cvetaevvitaliy/telemetry-system/doc/pic/GPS_module_1.png

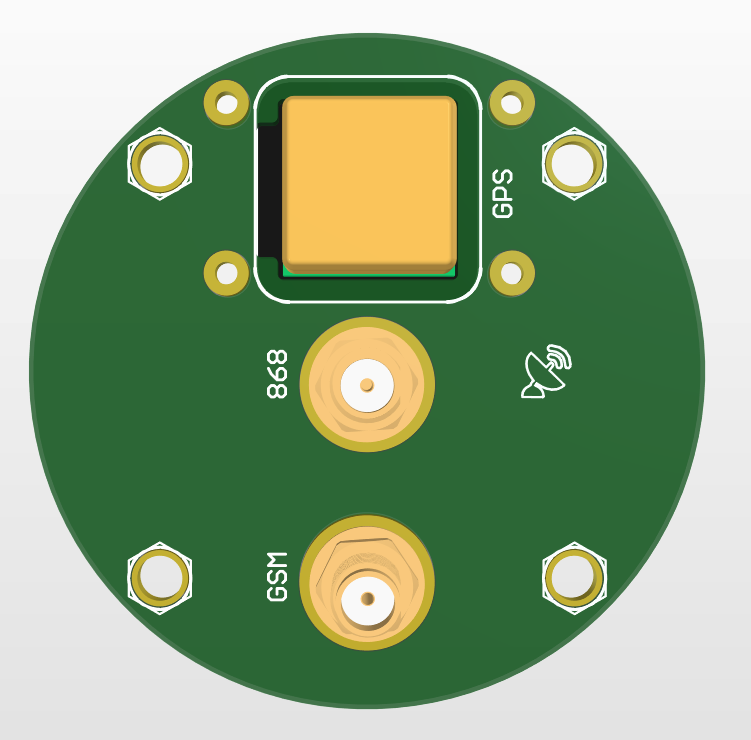
doc/pic/GPS_module_1.png
