cvetaevvitaliy/telemetry-system/doc/pic/GPS_module_2.png

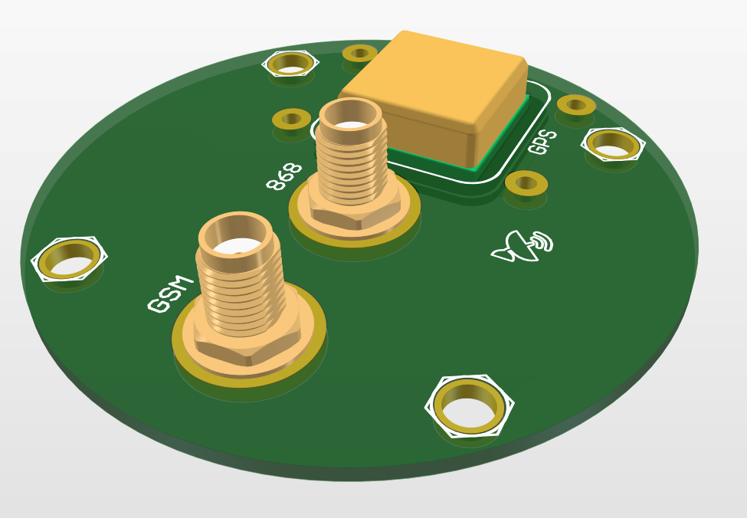
doc/pic/GPS_module_2.png
