cvetaevvitaliy/telemetry-system/doc/pic/Ground_station.png

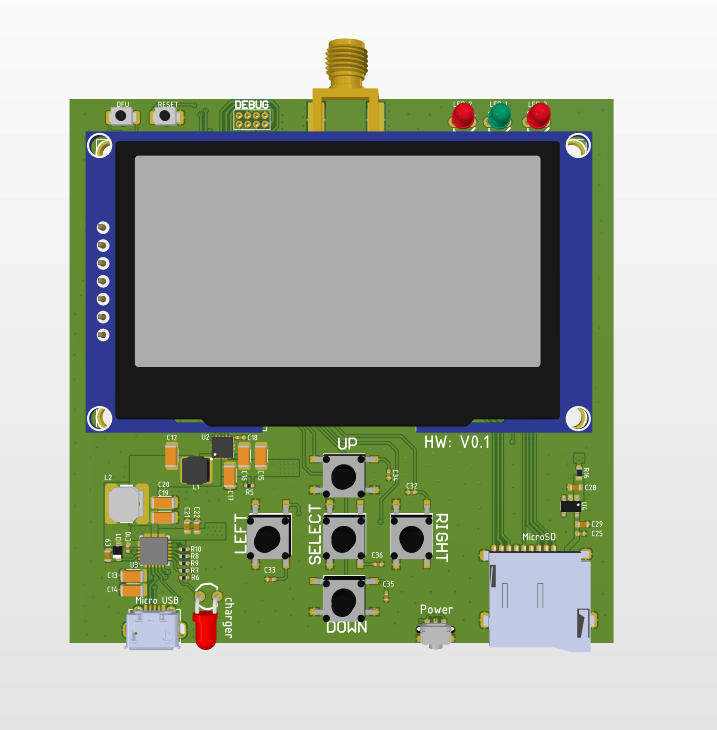
doc/pic/Ground_station.png
