cvetaevvitaliy/telemetry-system/doc/pic/MCU_module_B.png

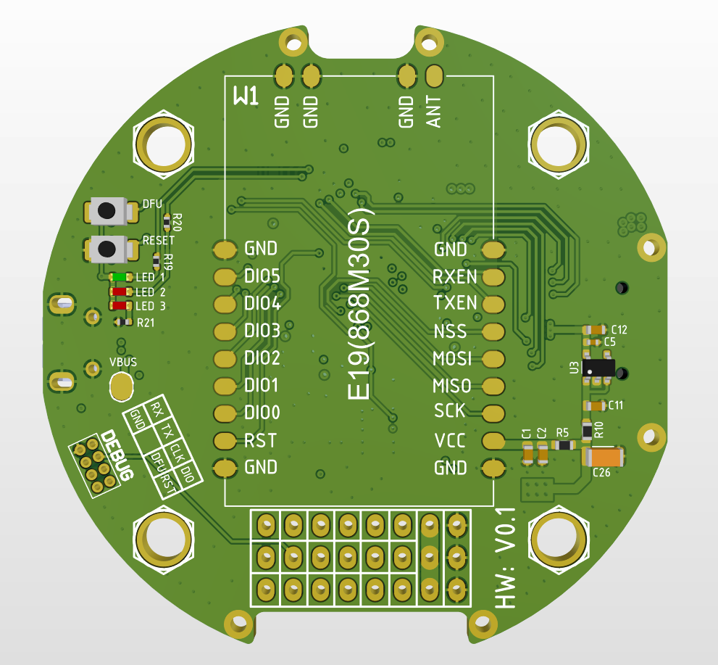
doc/pic/MCU_module_B.png
