cvetaevvitaliy/telemetry-system/doc/pic/MCU_module_T.png

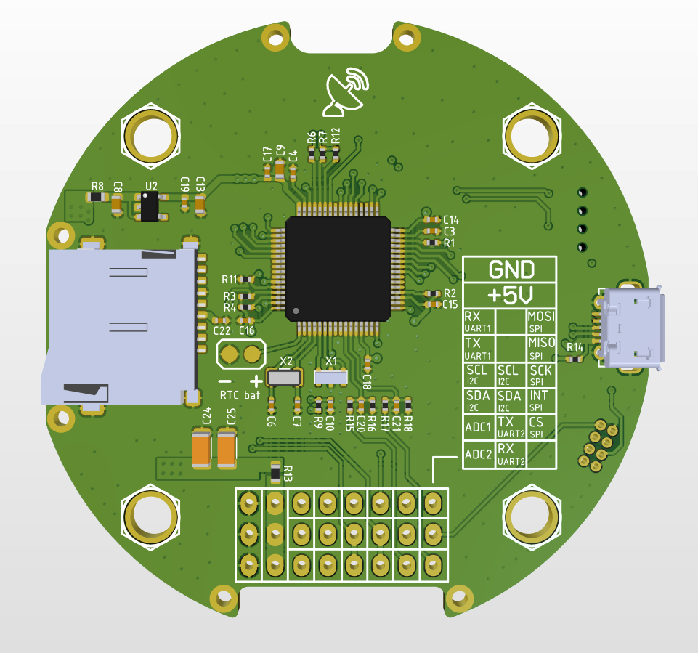
doc/pic/MCU_module_T.png
