cvetaevvitaliy/telemetry-system/doc/pic/POWER_module_B.png

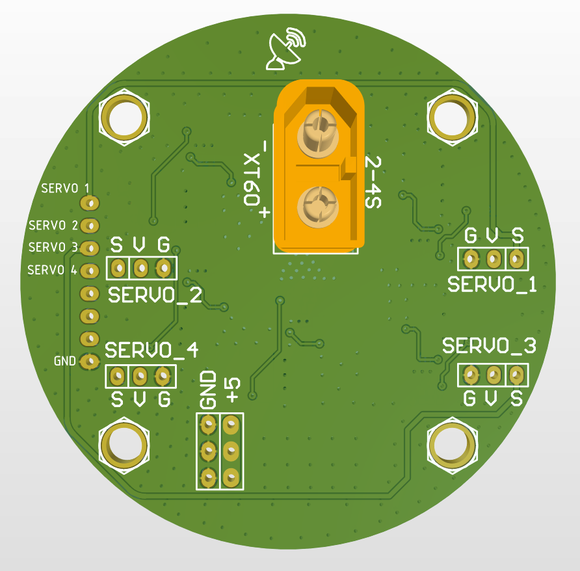
doc/pic/POWER_module_B.png
