cvetaevvitaliy/telemetry-system/doc/pic/POWER_module_T.png

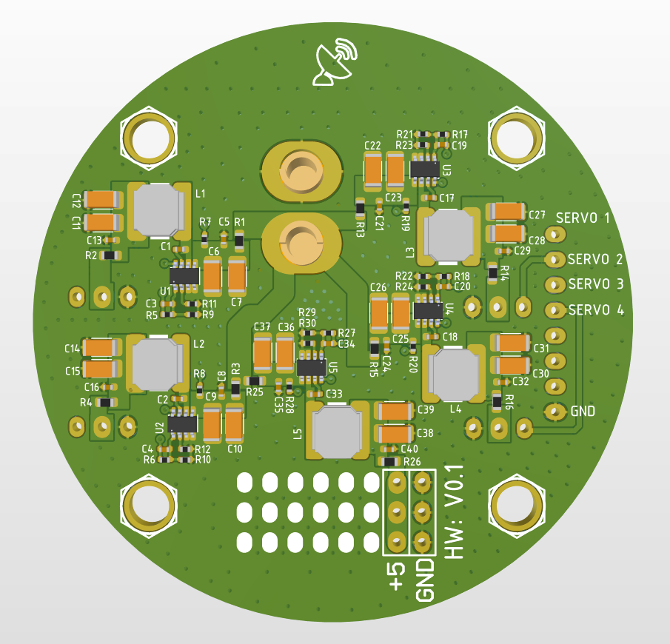
doc/pic/POWER_module_T.png
