cvetaevvitaliy/telemetry-system/doc/pic/SERVO_module_B.png

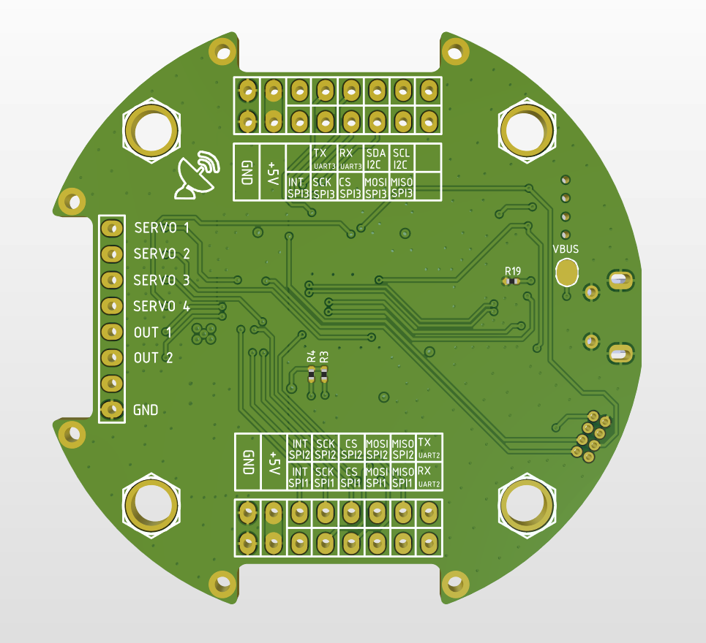
doc/pic/SERVO_module_B.png
