cvetaevvitaliy/telemetry-system/doc/pic/SERVO_module_T.png

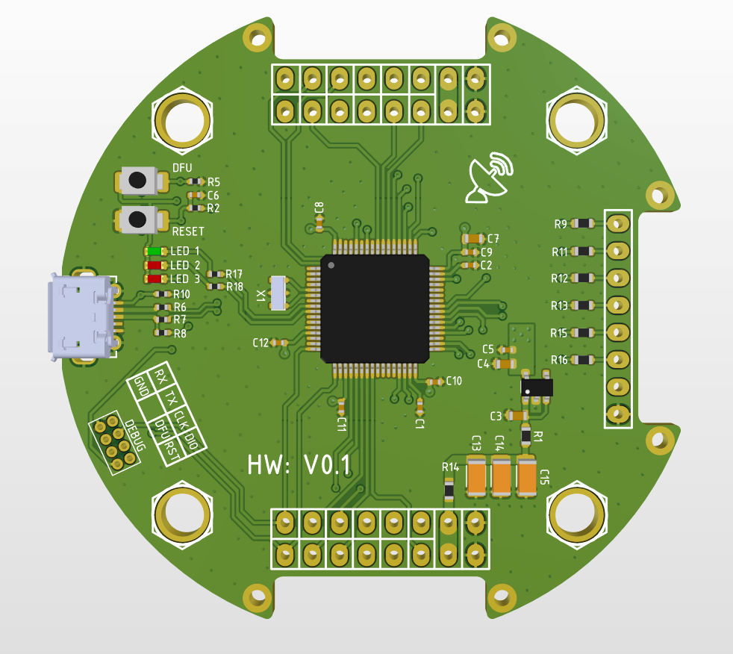
doc/pic/SERVO_module_T.png
