cvetaevvitaliy/telemetry-system/doc/pic/TX.png

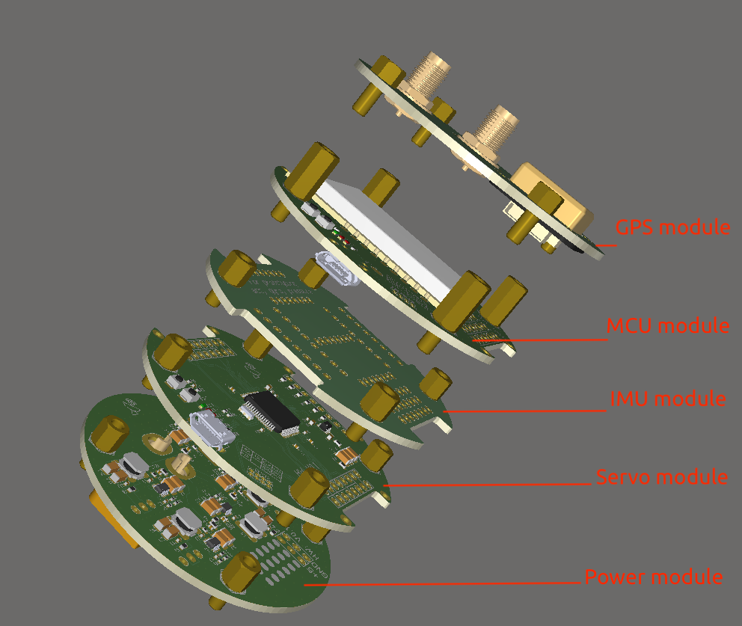
doc/pic/TX.png
