cvetaevvitaliy/telemetry-system/doc/pic/TX_assem.png

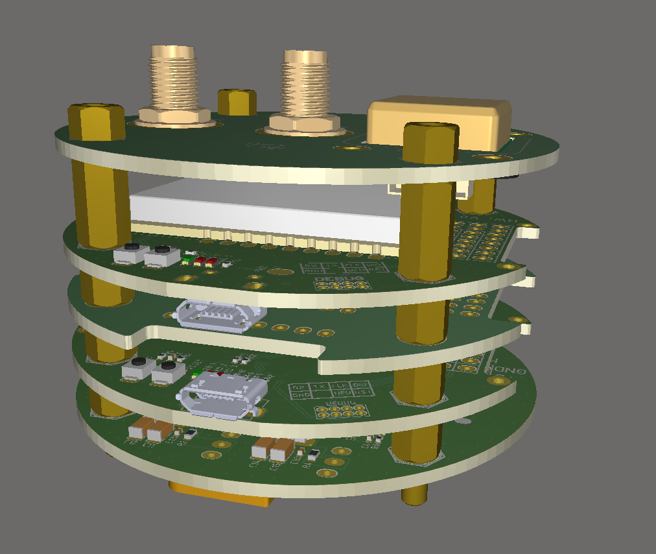
doc/pic/TX_assem.png
