cvetaevvitaliy/telemetry-system/src/components/README.md

# Components
The source code of the project components is stored here
------

### bq25895 source code
Source code for i2c charger chip

```
📦 bq25895
 ┣ 📜 bq2589x_charger.c
 ┣ 📜 bq2589x_charger.h
 ┗ 📜 bq2589x_reg.h
```
------

### CLI - Command Line Interface
Compact & Simple Command Line Interface for microcontrollers <br>
Uses ~2Kb Flash memory, ~1Kb RAM memory

```
📦 cli
 ┣ 📂 lib
 ┃ ┣ 📜 cli_input.c
 ┃ ┣ 📜 cli_input.h
 ┃ ┣ 📜 cli_log.c
 ┃ ┣ 📜 cli_log.h
 ┃ ┣ 📜 cli_queue.c
 ┃ ┣ 📜 cli_queue.h
 ┃ ┣ 📜 cli_time.c
 ┃ ┗ 📜 cli_time.h
 ┣ 📜 cli.c
 ┣ 📜 cli.h
 ┣ 📜 cli_config.h       - config CLI header file
 ┣ 📜 cli_io.c
 ┗ 📜 cli_io.h
```

------

### LoRa transceiver source code
Source code for SX1276 chip

```
📦 sx1276
 ┣ 📜 radio.h
 ┣ 📜 sx1276-board.h
 ┣ 📜 sx1276.c
 ┣ 📜 sx1276.h
 ┣ 📜 sx1276Regs-Fsk.h
 ┗ 📜 sx1276Regs-LoRa.h
```

------

*the document will be updated as the project develops
