cvetaevvitaliy/telemetry-system/doc/HW/Ground_station_RX.pdf

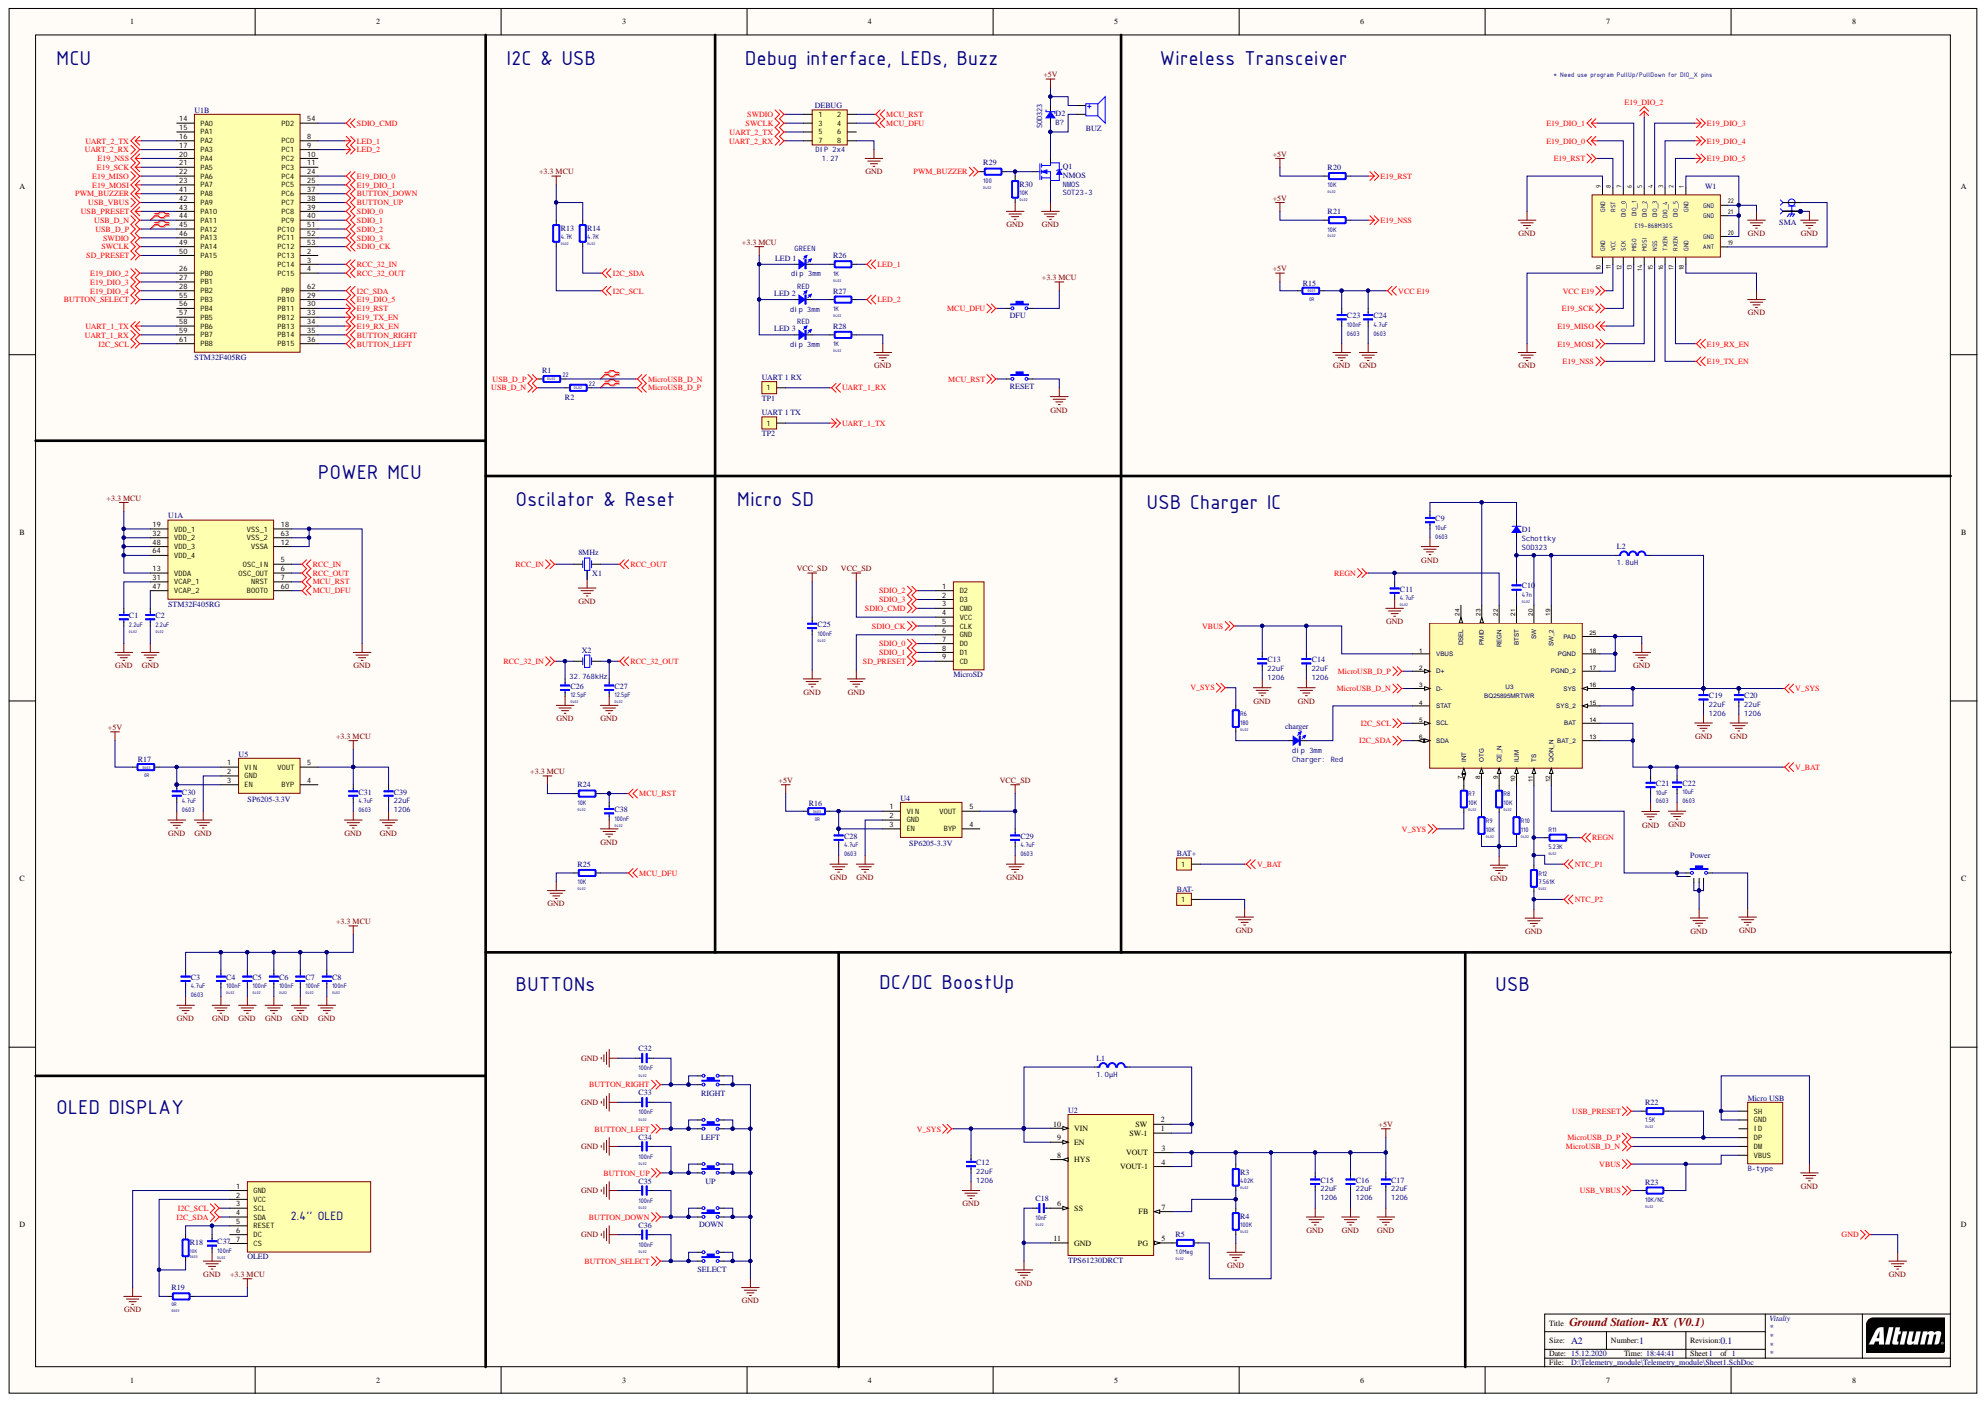
[picture p15: page 1]

* Need use program PullUp/PullDown for DIO_X pins

GND 1 DIO_5 2 DIO_4 3 DIO_3 4 DIO_2 5 DIO_1 6 DIO_0 7 RST 8 GND 9 GND 10

8MHz X1 +3.3 MCU | VCC_SD +5V VCC_SD

VDDA 13

I2C_SCL I2C_SDA | SCL 3

VCC 2

Ground Station- RX (V0.1) Title | Vitaliy * * * *

Size: A2 | Number: 1 | Revision: 0.1

Date: 15.12.2020 Time: 18:44:41 | | Sheet 1 of 1

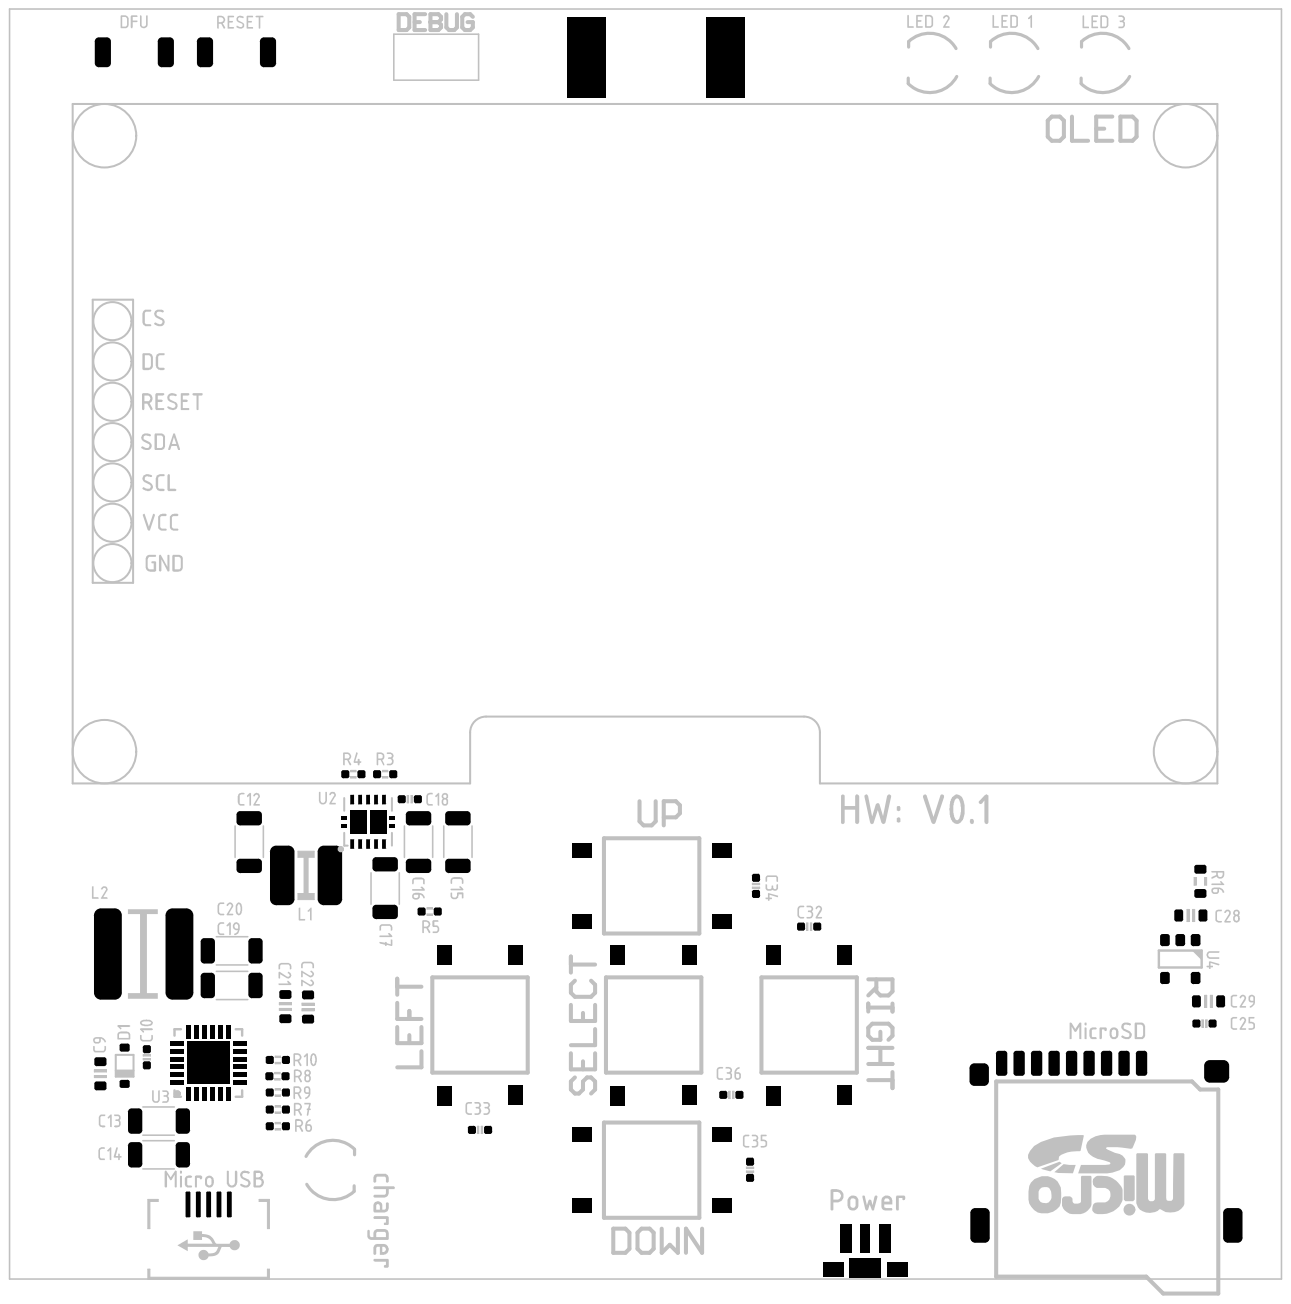
[picture p16: page 2]

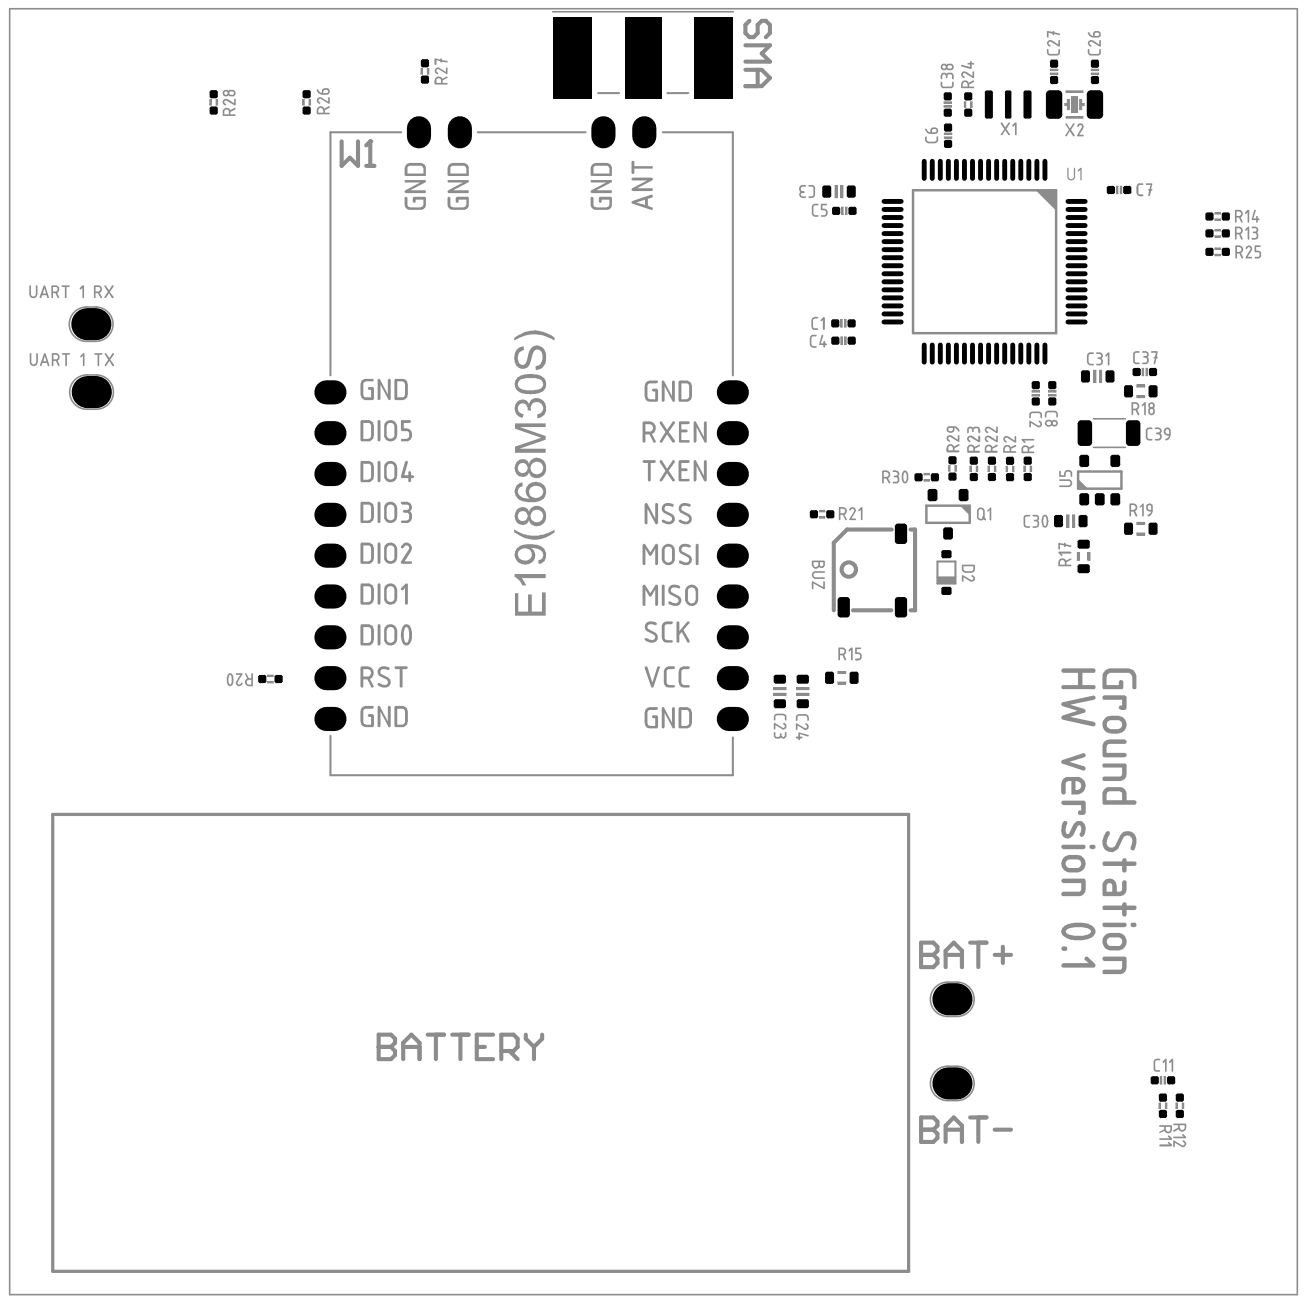
[picture p17: page 3]
