cvetaevvitaliy/telemetry-system/doc/HW/Telemetry_module_TX_MCU.pdf

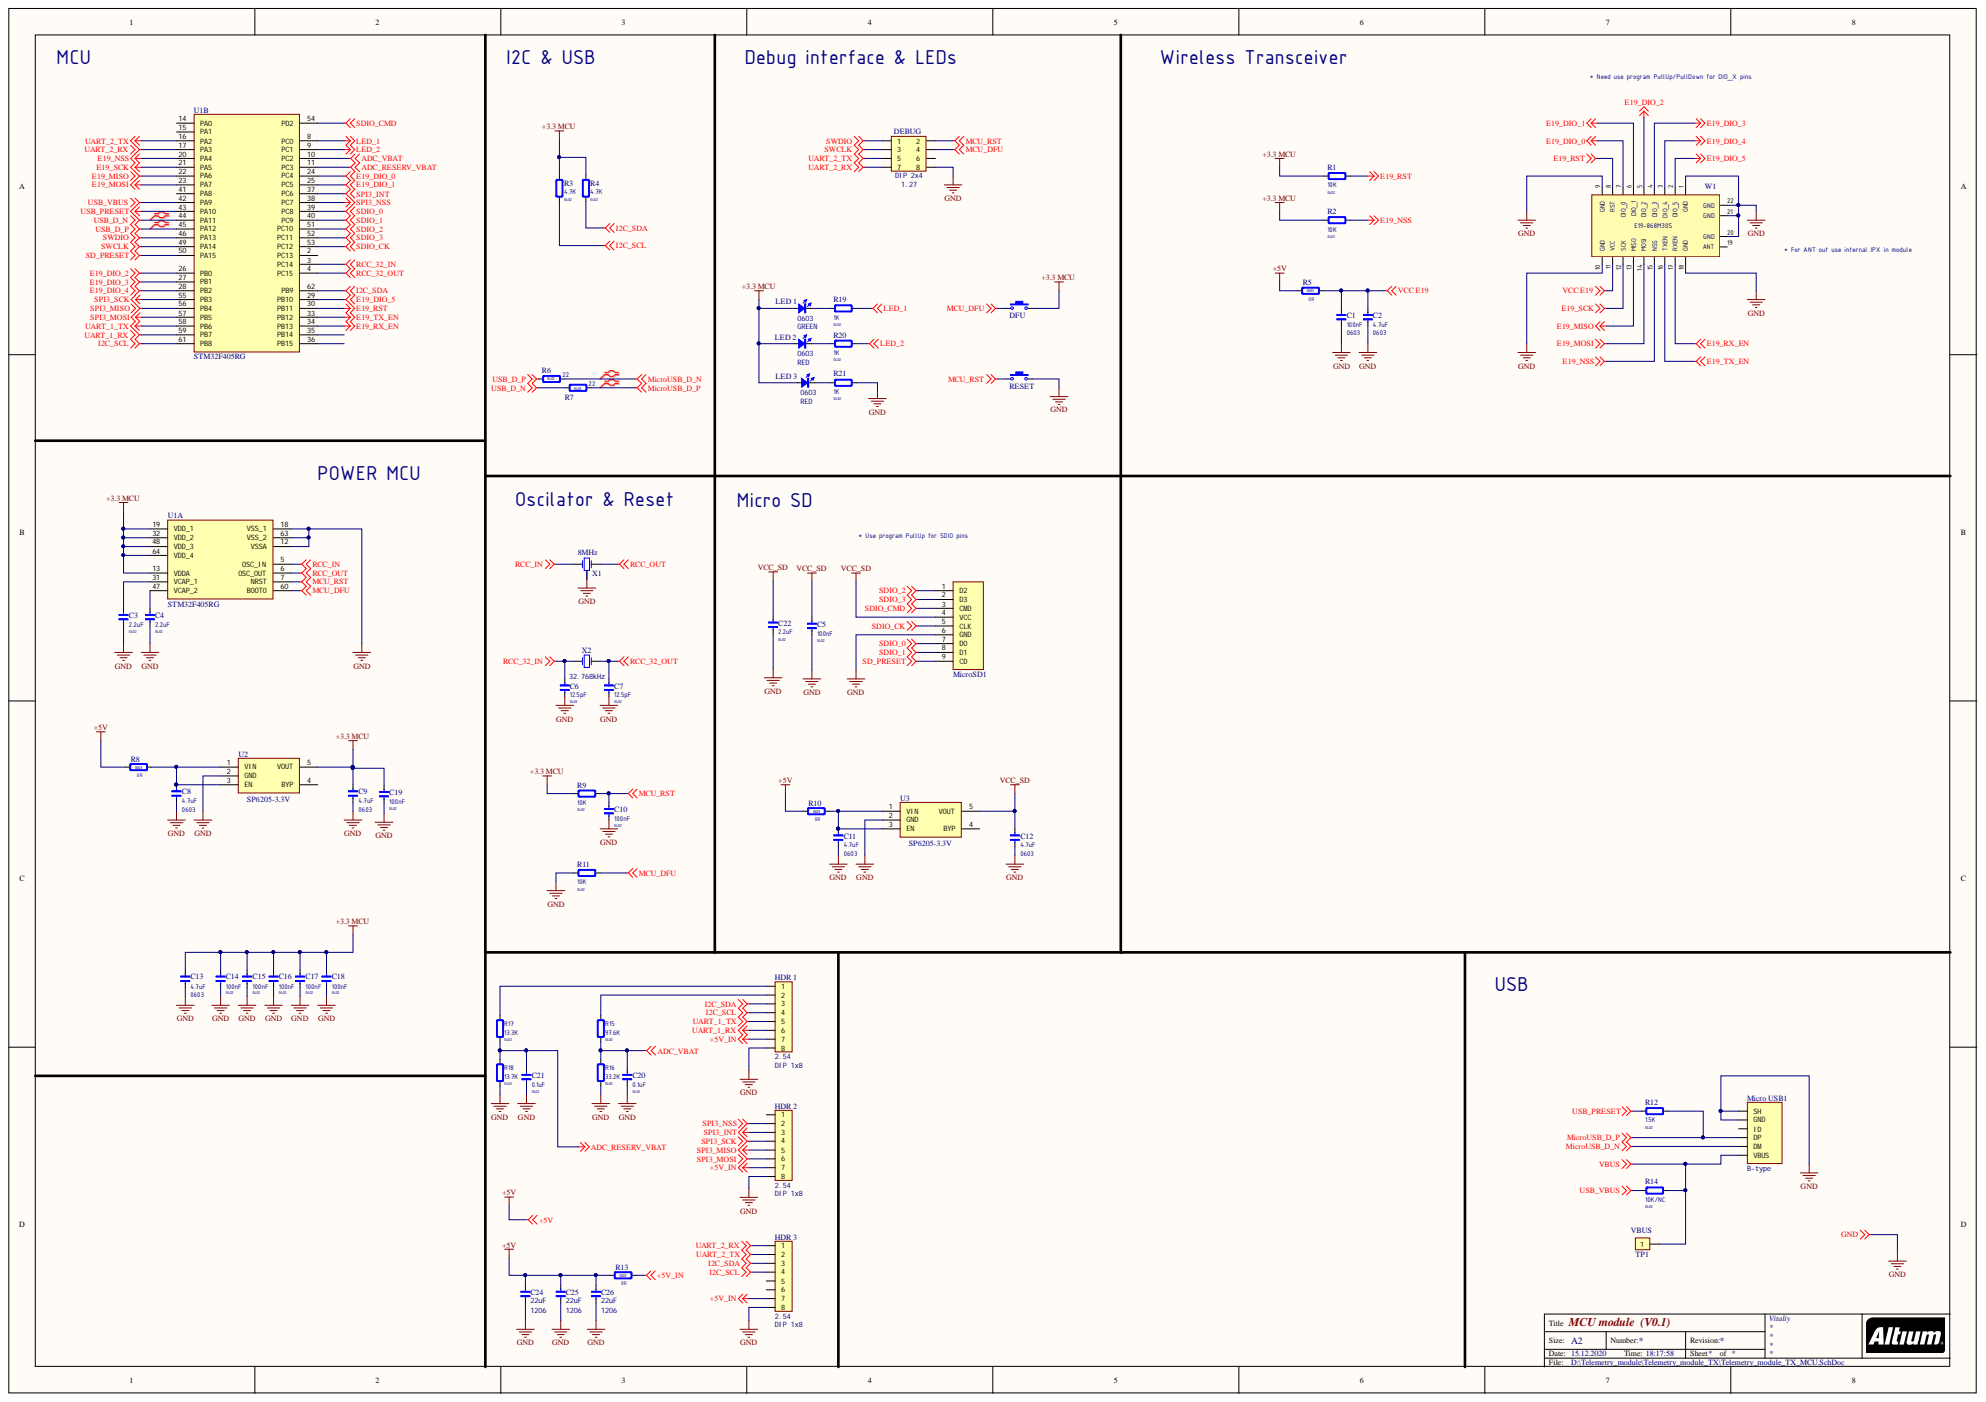
[picture p18: page 1]

* Need use program PullUp/PullDown for DIO_X pins

GND 1 DIO_5 2 DIO_4 3 DIO_3 4 DIO_2 5 DIO_1 6 DIO_0 7 RST 8 GND 9 GND 10

* For ANT out use internal IPX in module

Oscilator & Reset 8MHz X1 C7 12.5pF 0402 | Micro SD * Use program PullUp for SDIO pins VCC_SD VCC_SD VCC_SD +5V VCC_SD

VDDA 13

MCU module (V0.1) Title | Vitaliy * * * *

Size: A2 | Number: * | Revision: *

Date: 15.12.2020 Time: 18:17:58 | | Sheet * of *

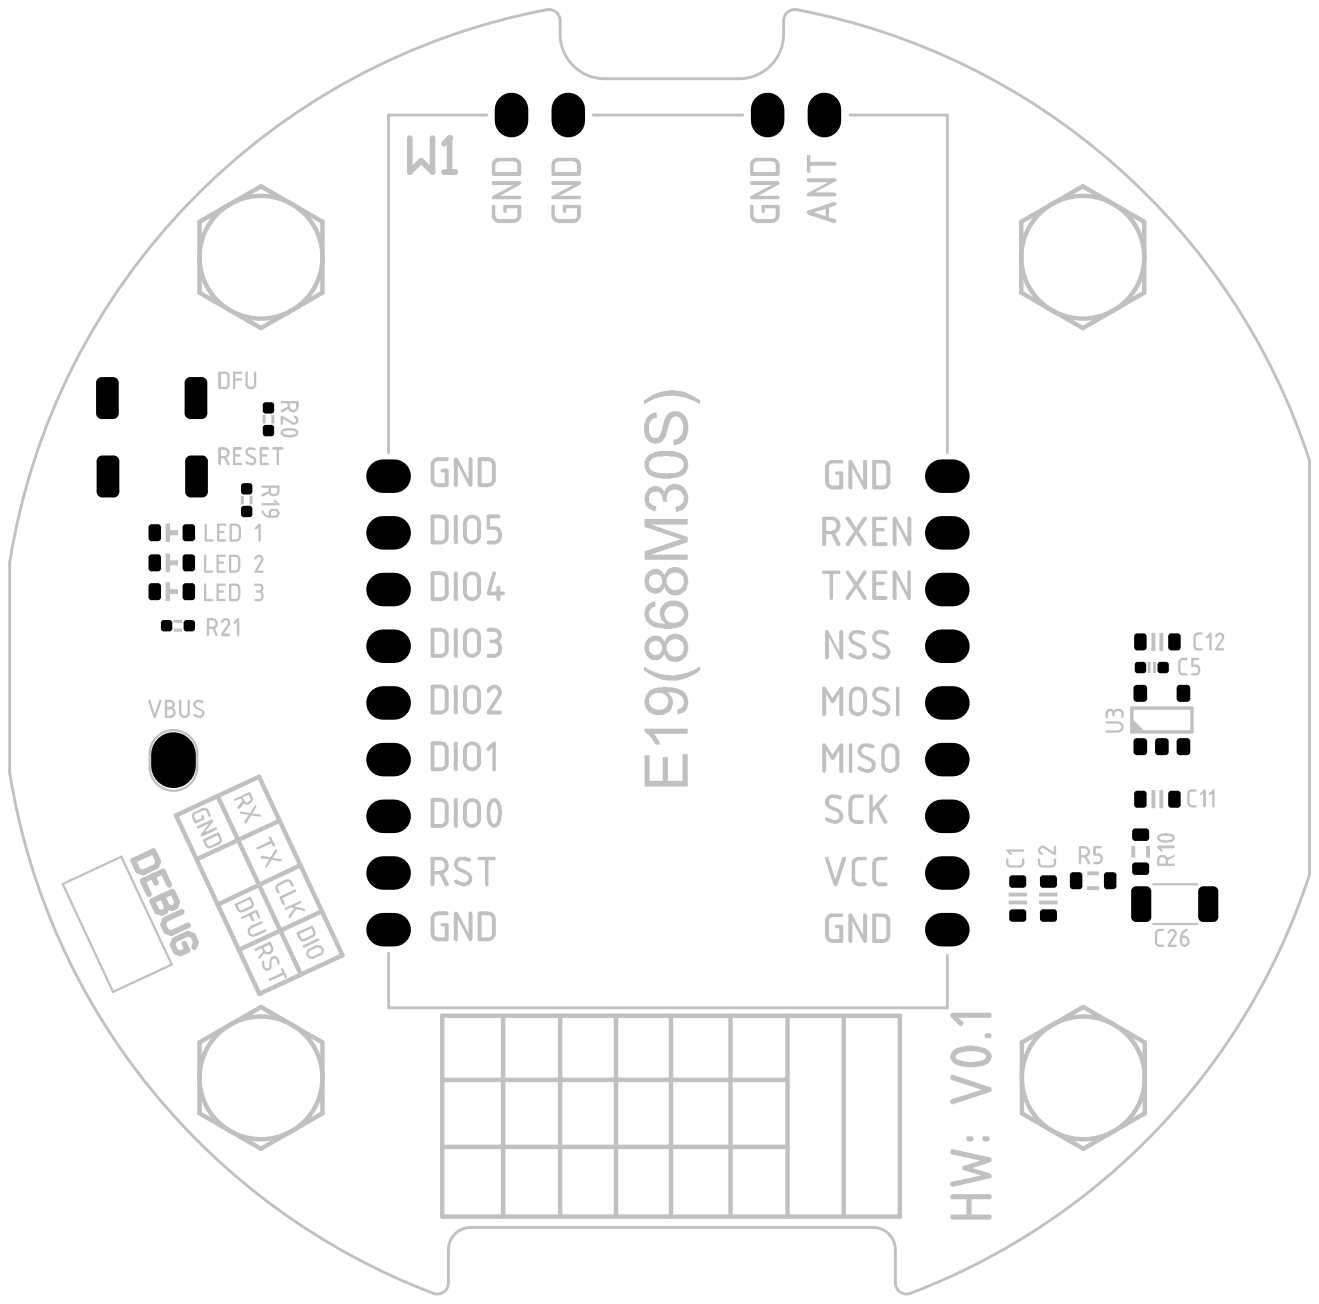
[picture p19: page 2]

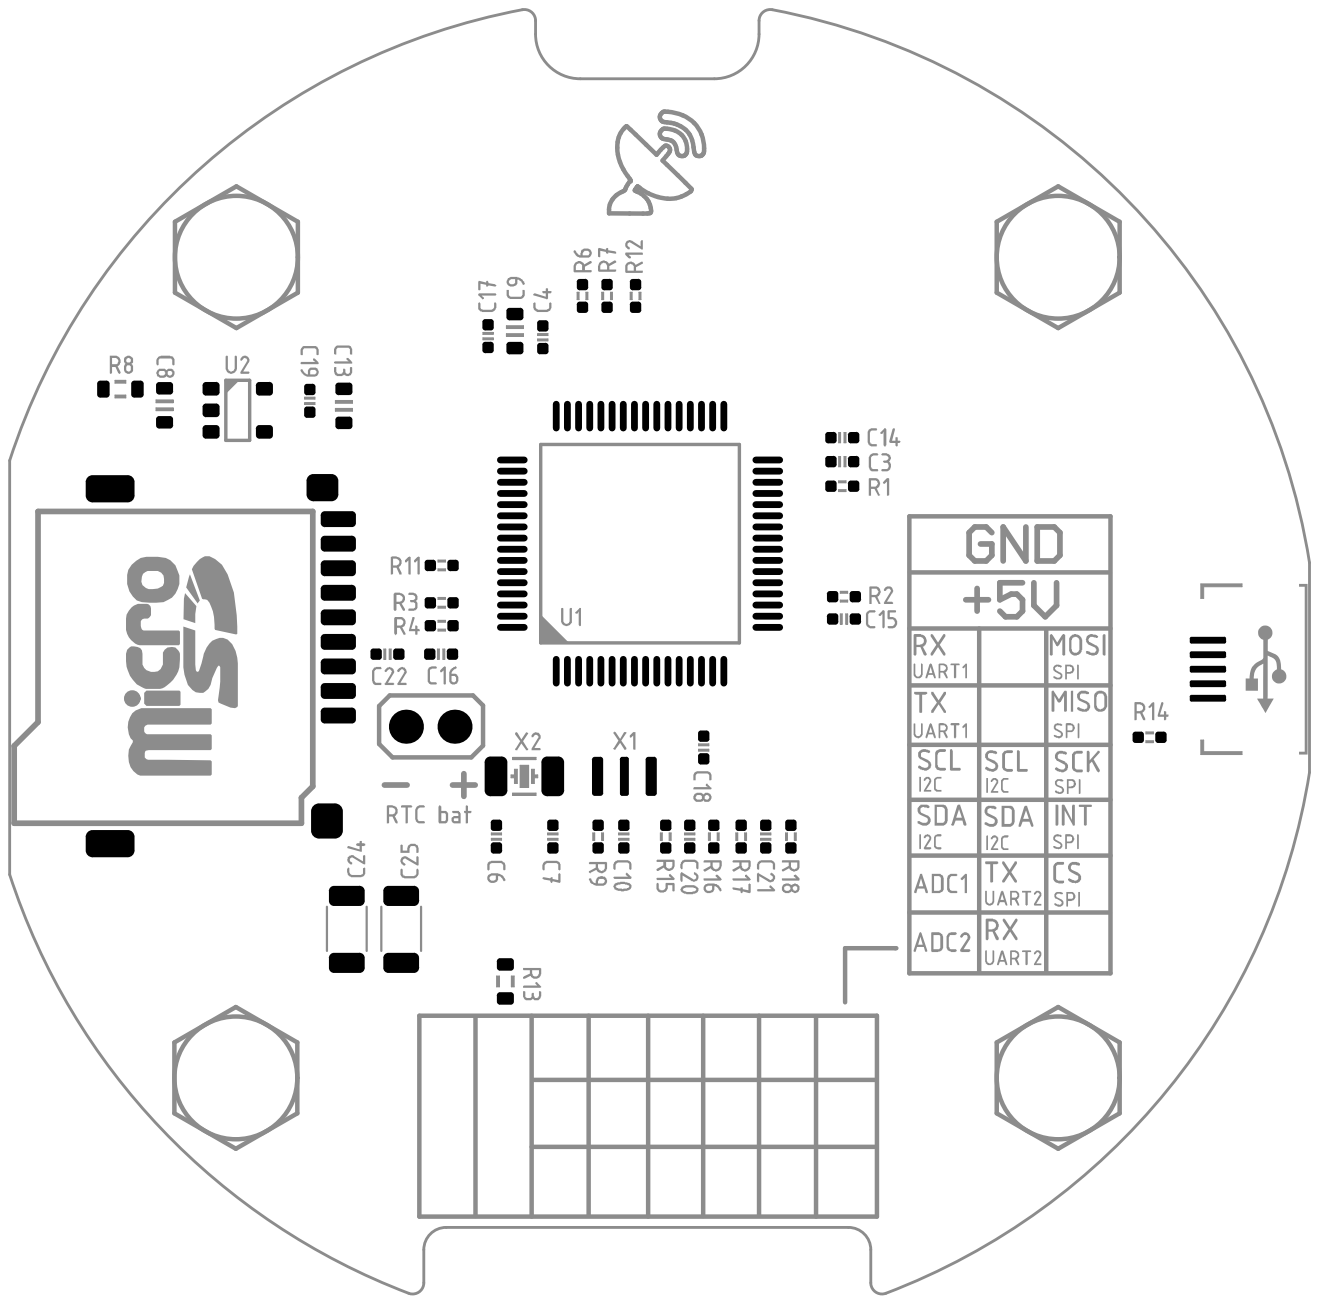
[picture p20: page 3]
