cvetaevvitaliy/telemetry-system/doc/HW/Telemetry_module_TX_Power.pdf

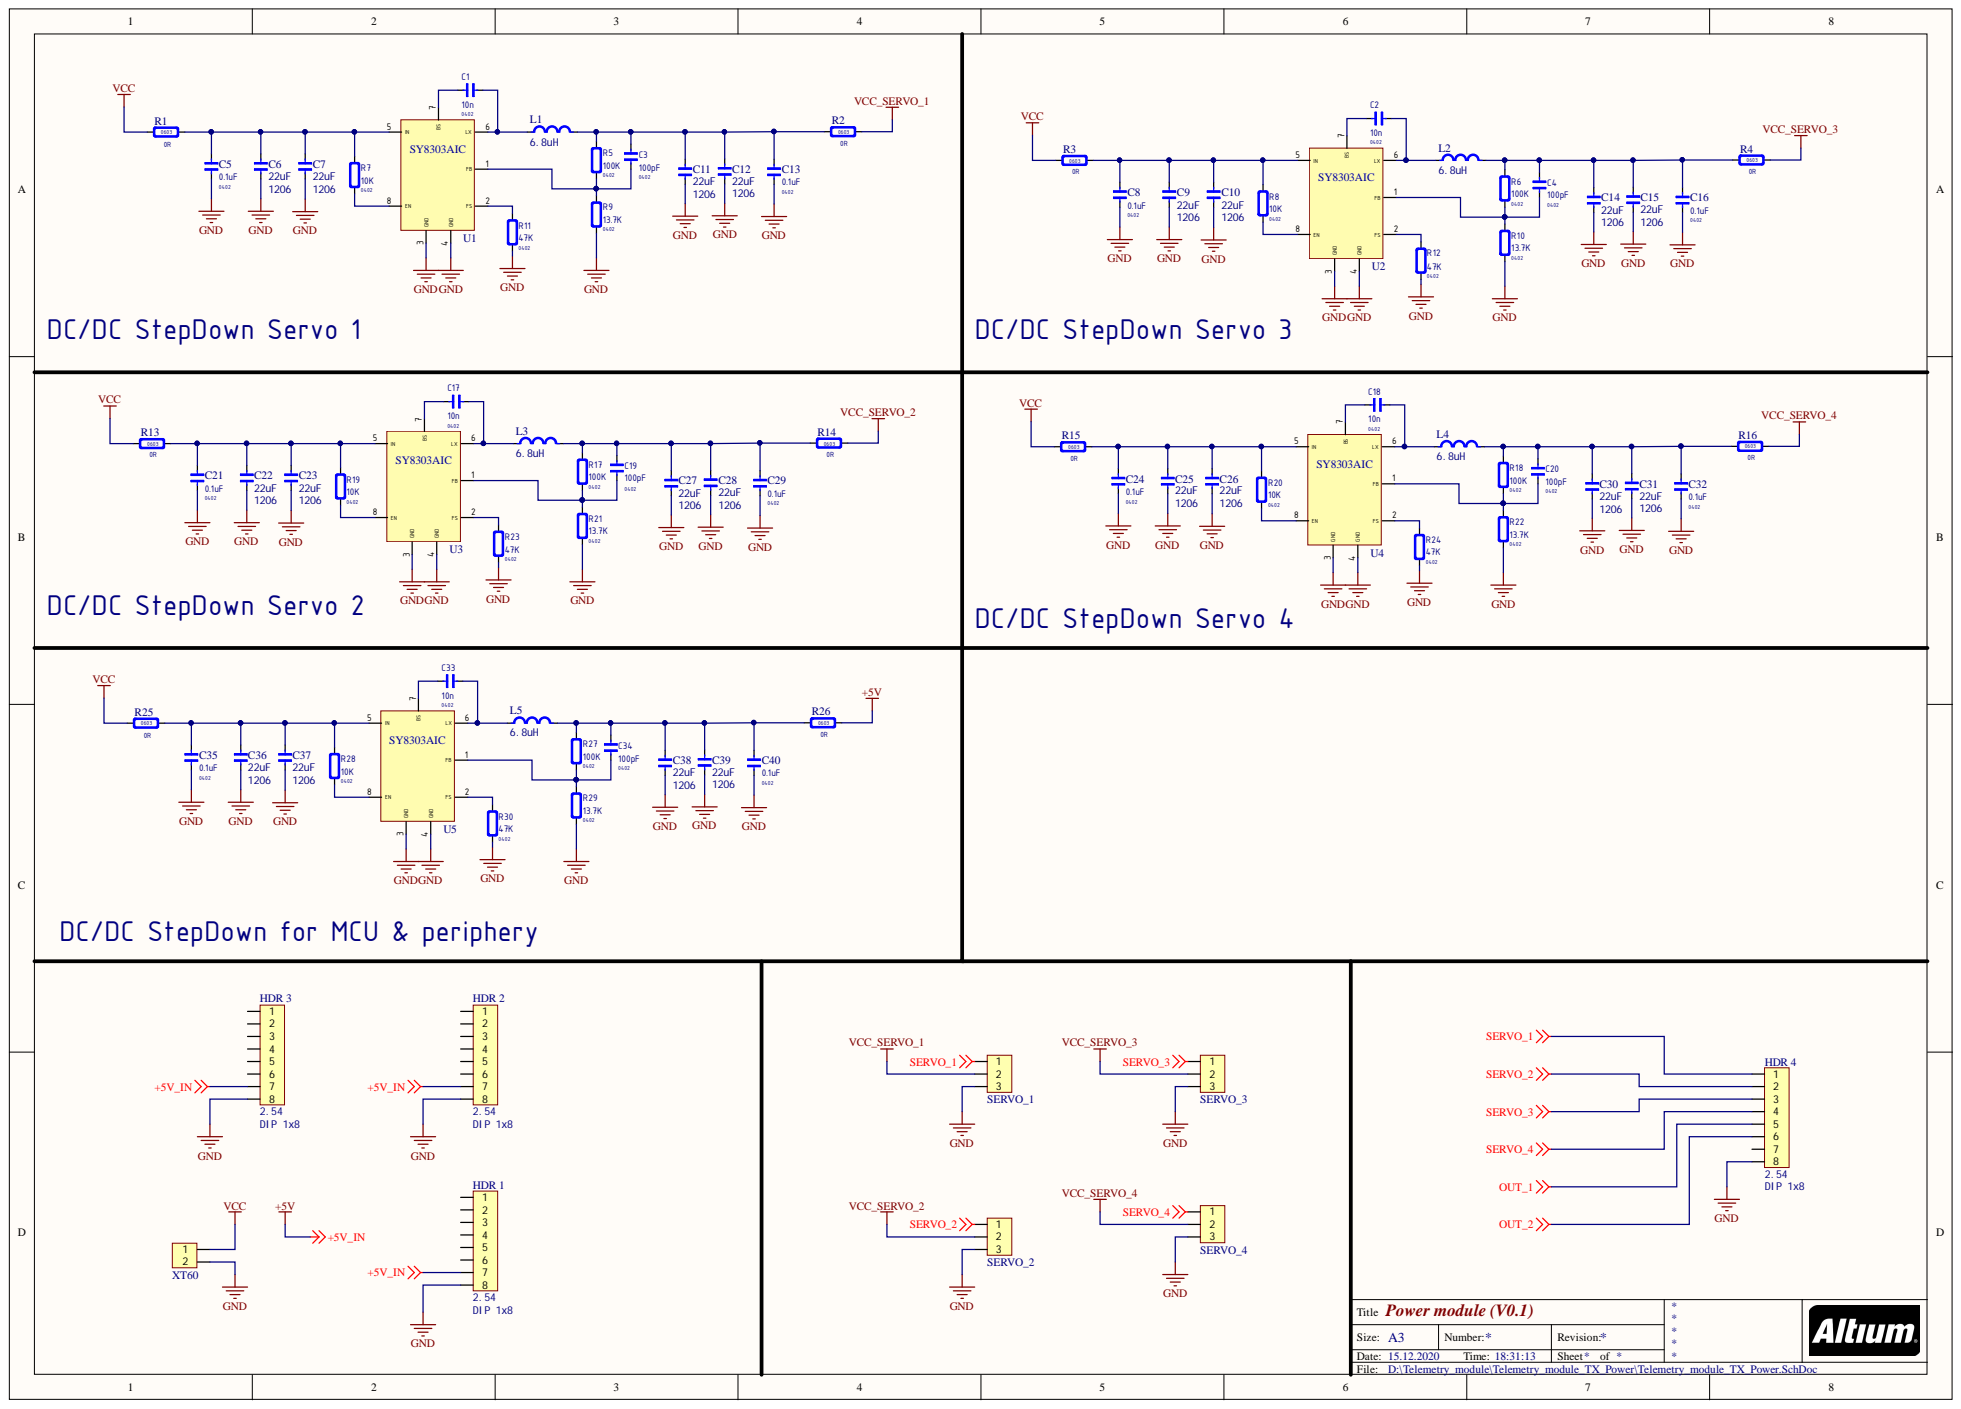
[picture p21: page 1]

DC/DC StepDown Servo 1

DC/DC StepDown Servo 3

DC/DC StepDown for MCU & periphery

Power module (V0.1) Title | * * * * *

Size: A3 | Number: * | Revision: *
Date: 15.12.2020 Time: 18:31:13 | | Sheet * of *

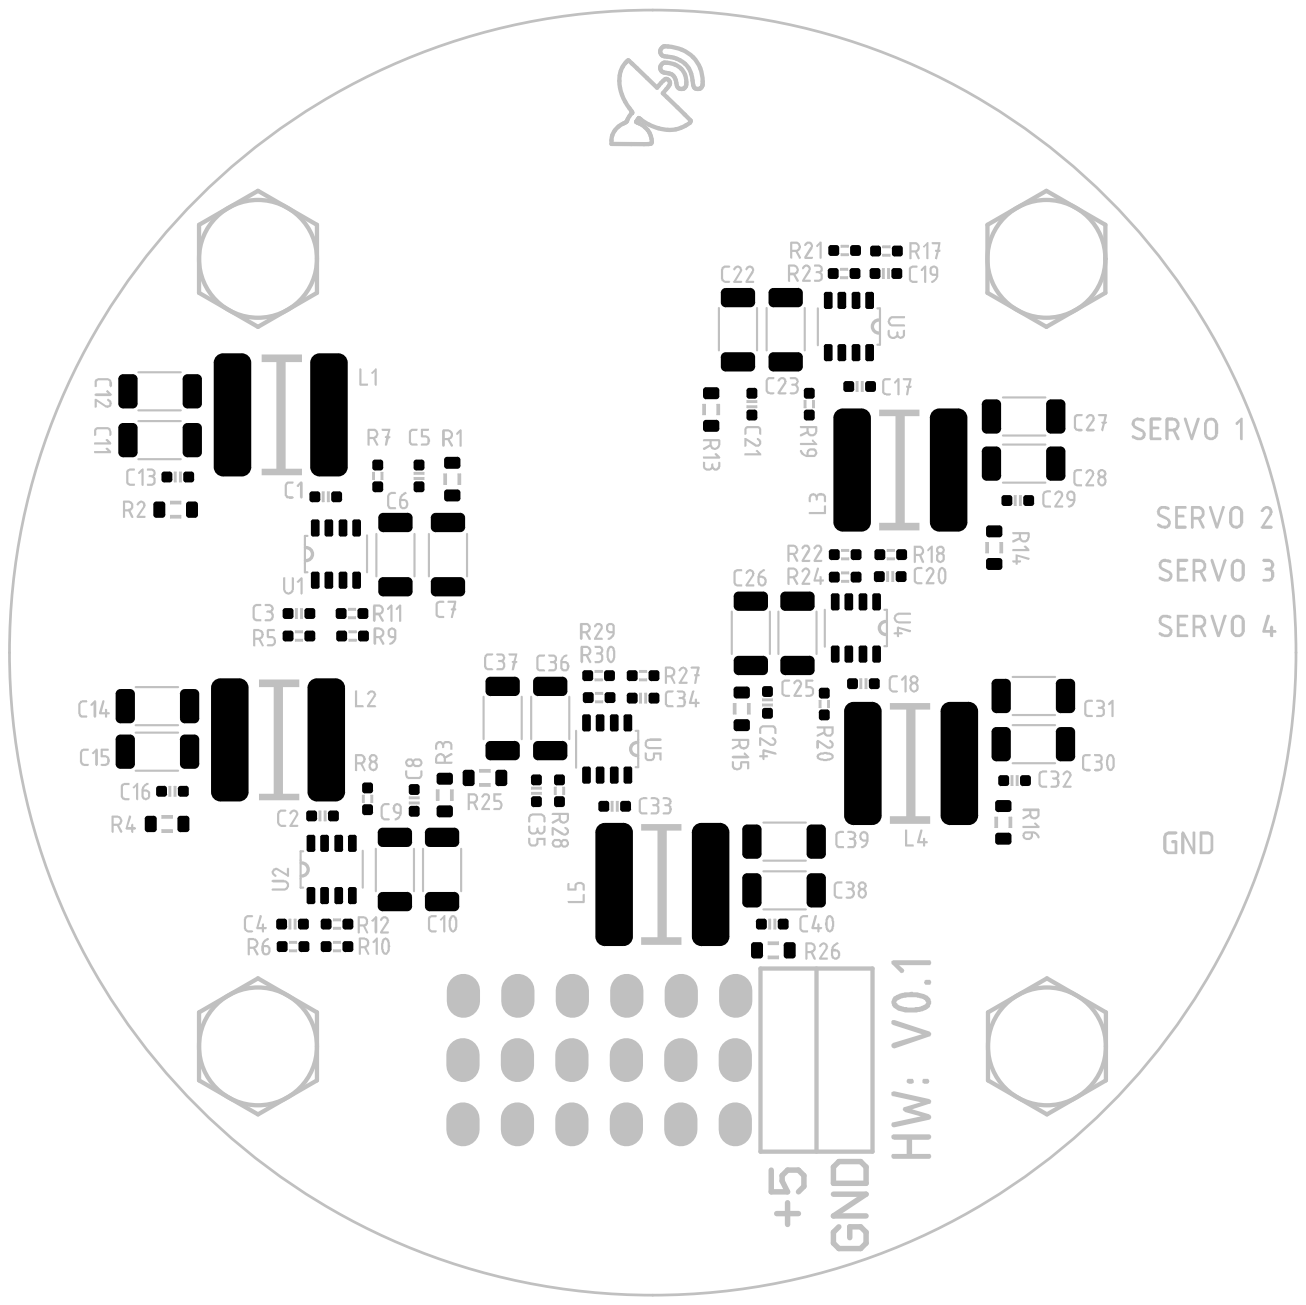
[picture p22: page 2]

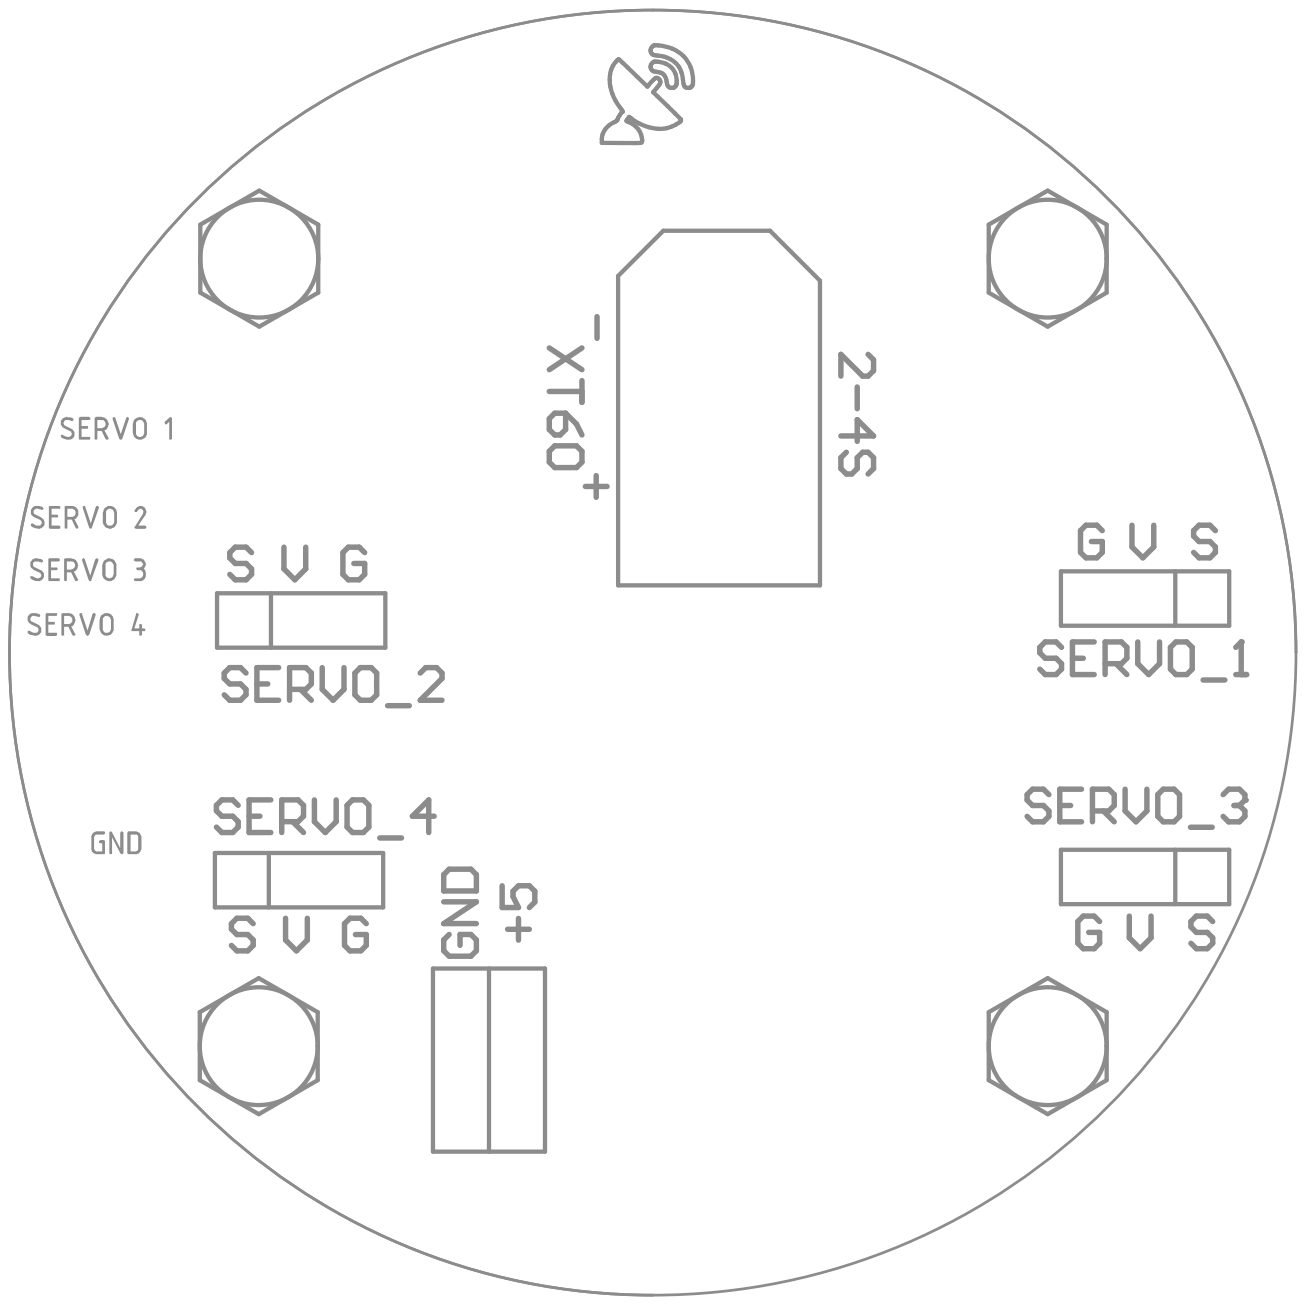
[picture p23: page 3]
