cvetaevvitaliy/telemetry-system/doc/HW/Telemetry_module_TX_SERVO.pdf

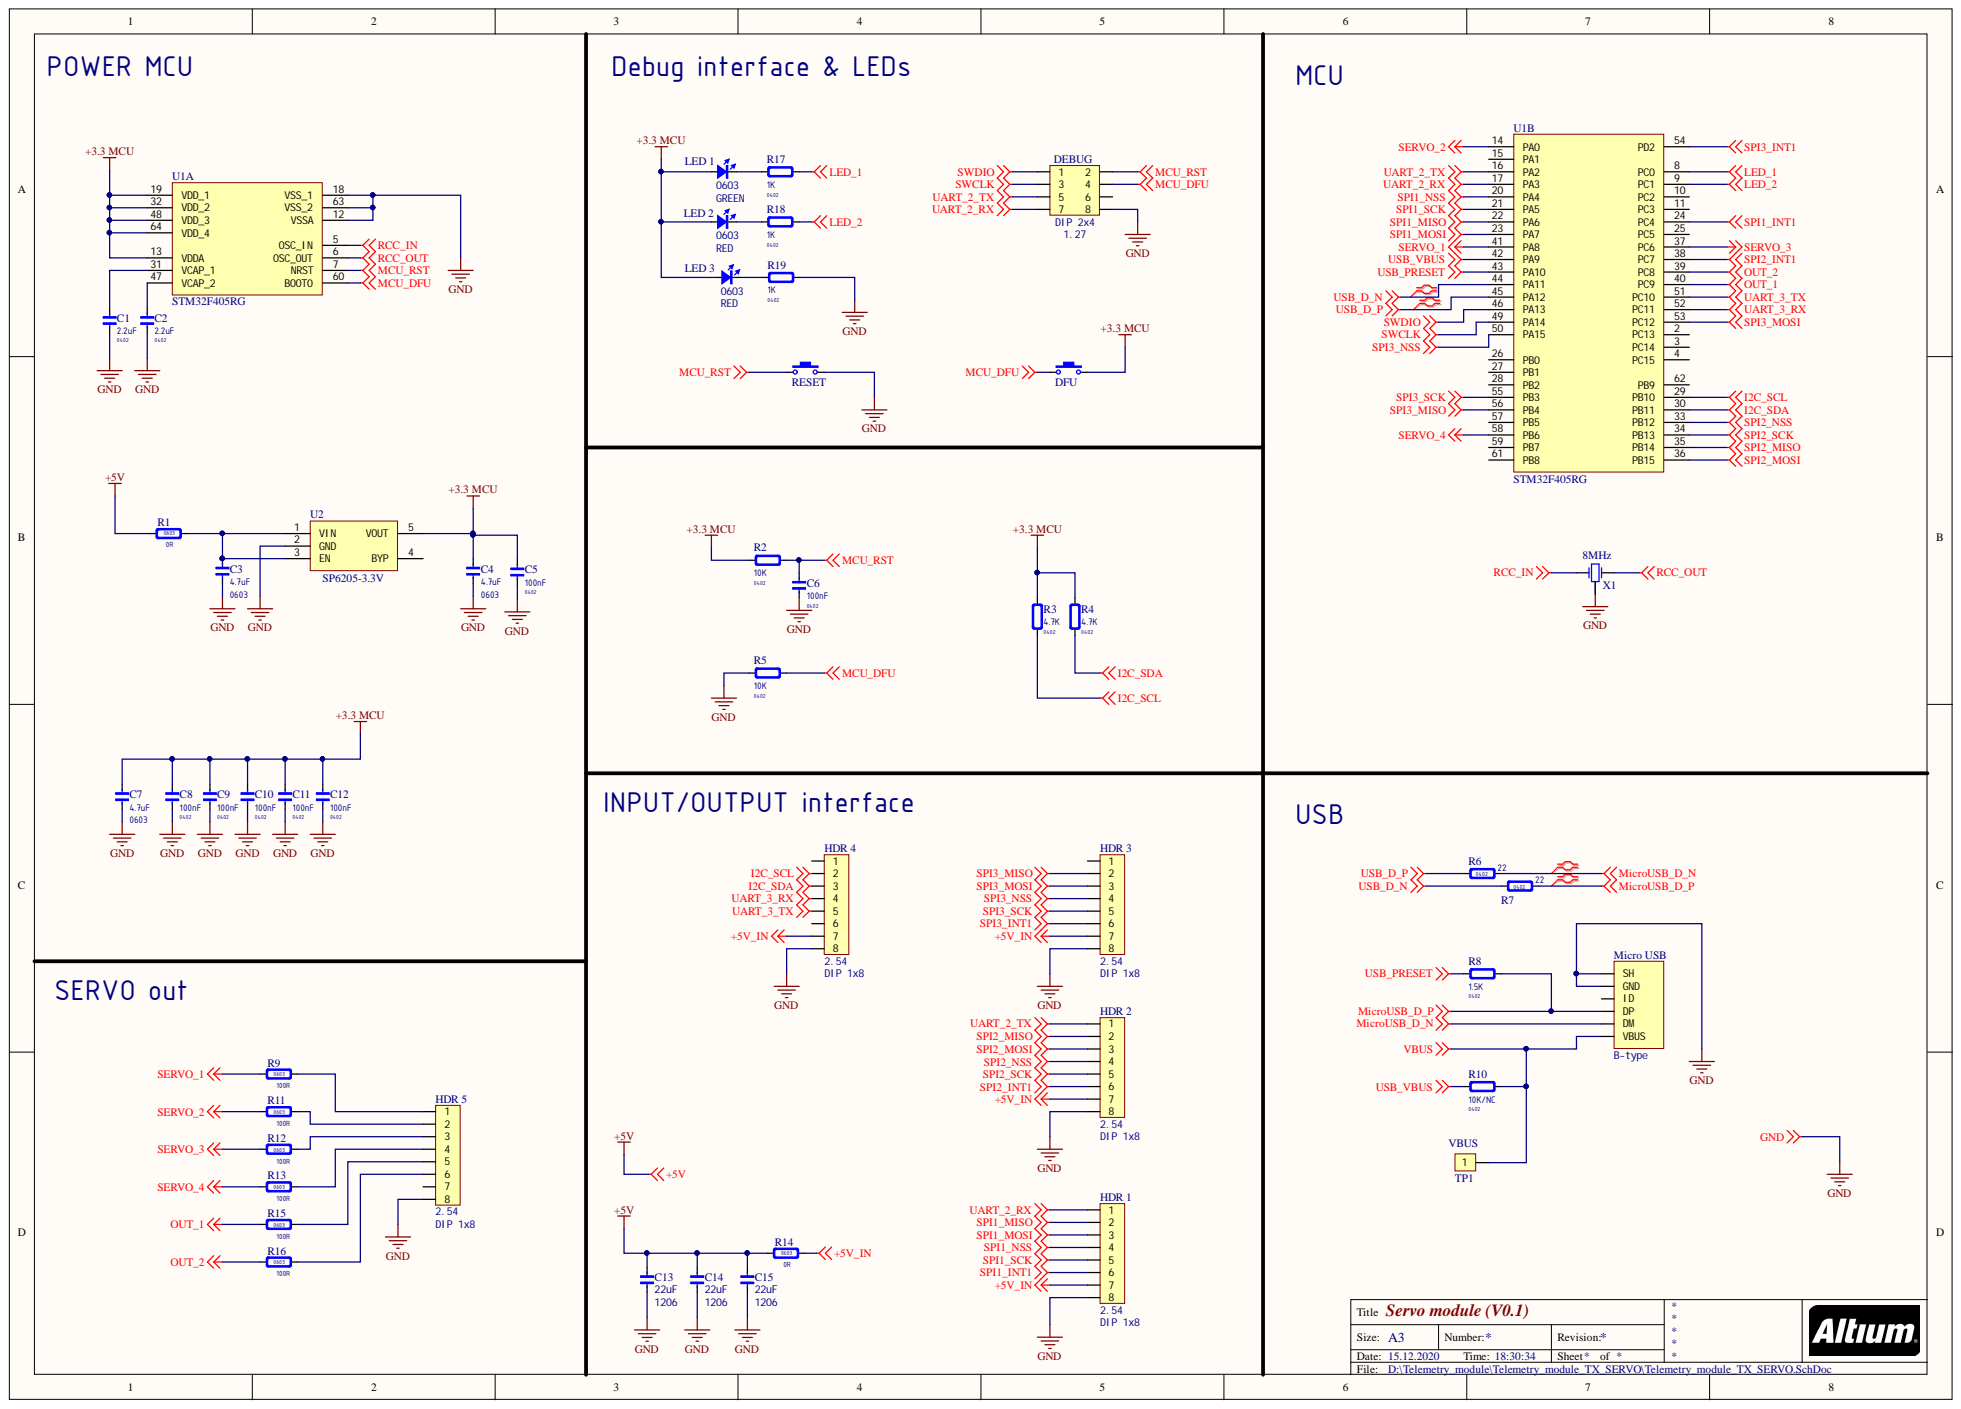
[picture p24: page 1]

PA12 45
PA13 46
PA14 49
PA15 50

Servo module (V0.1) Title | * * * * *

Size: A3 | Number: * | Revision: *
Date: 15.12.2020 Time: 18:30:34 | | Sheet * of *

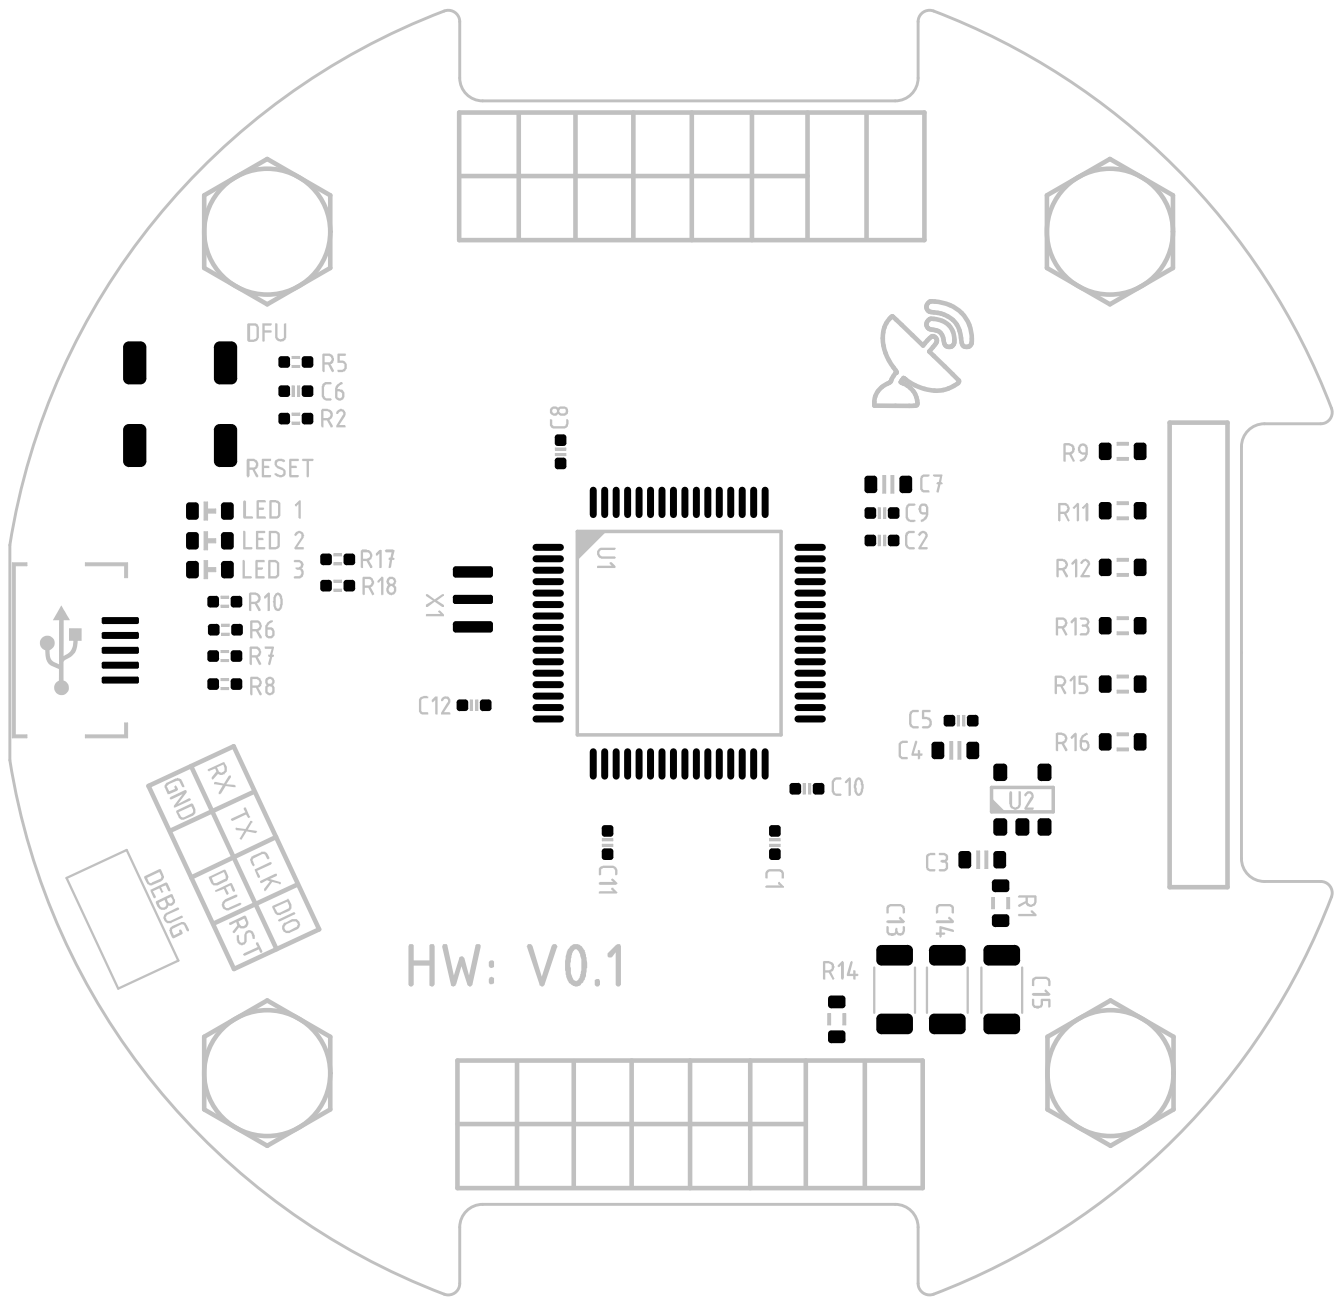
[picture p25: page 2]

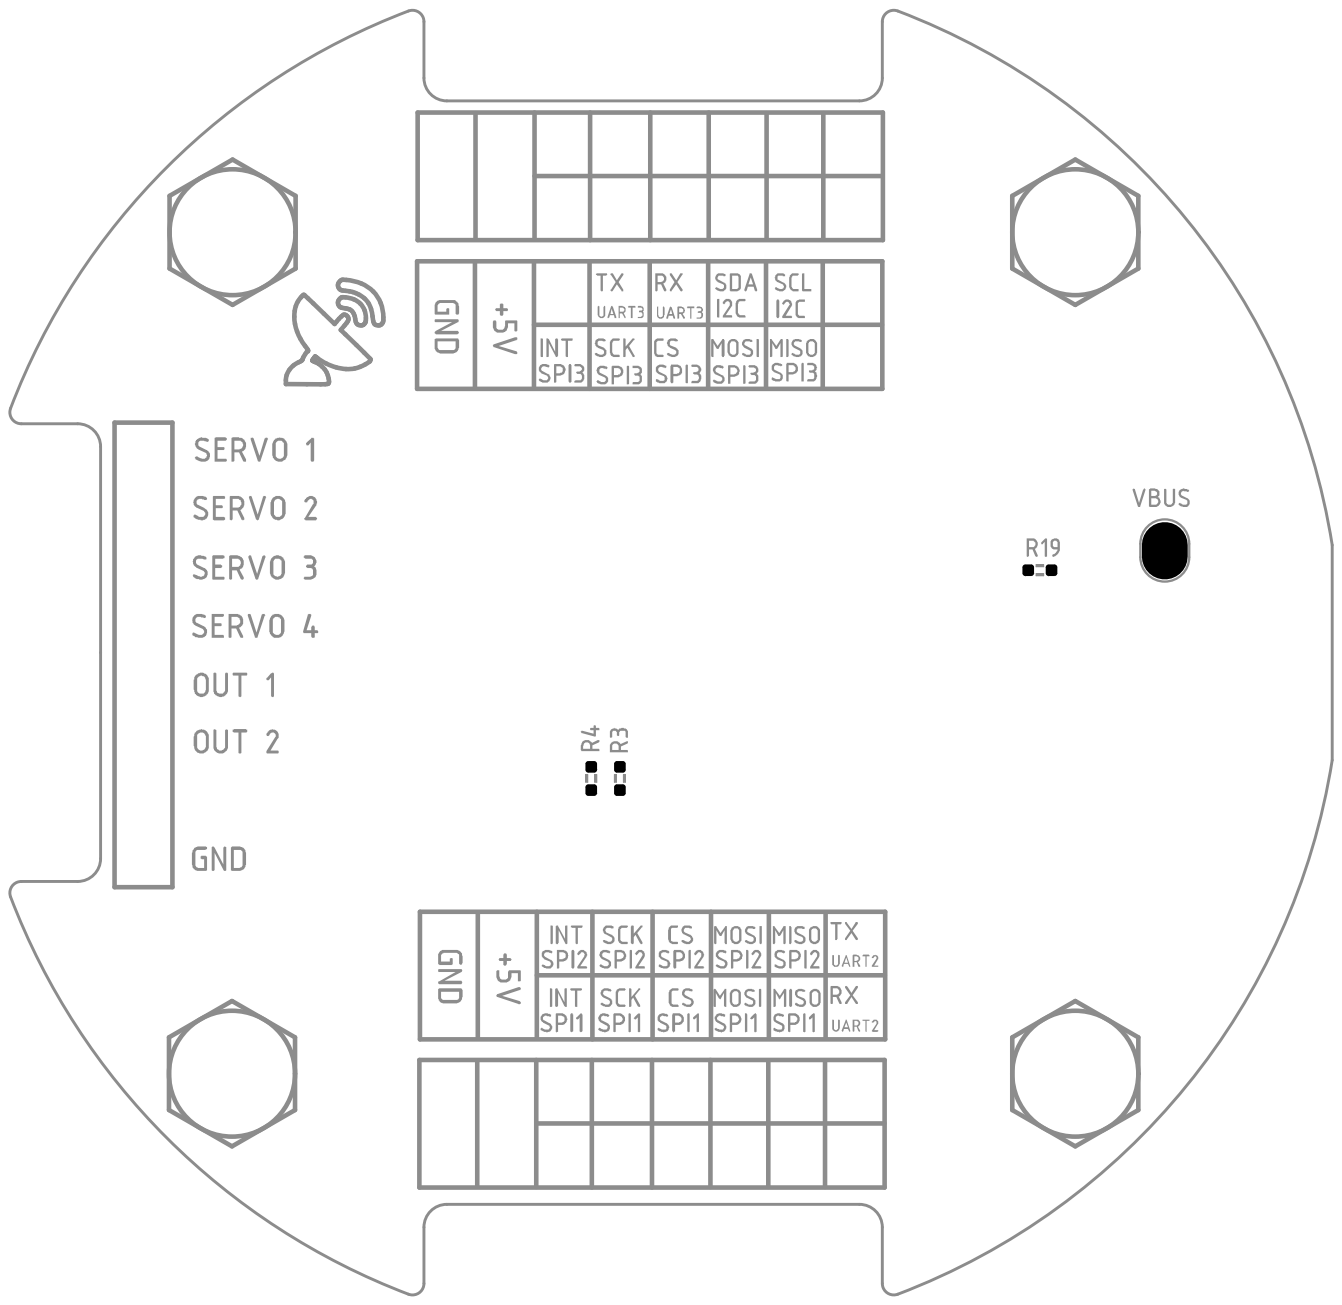
[picture p26: page 3]
