cvetaevvitaliy/telemetry-system/src/tx_module/services/gps/gps_service.c

/*
 * This file is part of "Telemetry system" project.
 *
 * "Telemetry system" are free software. You can redistribute
 * this software and/or modify this software under the terms of the
 * GNU General Public License as published by the Free Software
 * Foundation, either version 3 of the License, or (at your option)
 * any later version.
 *
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
 * If not, see <http://www.gnu.org/licenses/>.
 */
#include "gps_service.h"
#include "stm32f4xx_hal.h"
#include "hardware_init.h"
#include "cmsis_os.h"
#include "minmea.h"
#include "cli.h"
#include "sd_logger.h"

#define GPS_UART_BUFFER     160

extern UART_HandleTypeDef huart1;

void _gps_parser(uint8_t *data);


typedef struct {
    uint8_t gps_buffer[GPS_UART_BUFFER];
    uint16_t in_ptr;
    bool find_header;
    bool data_ready;
} GPS_State_t;


static uint8_t ch;
FAST_RAM GPS_State_t GPS_State = {0};
GPS_Data_t GPS_Data = {0};


void gps_service_init(void)
{
    MX_DMA_Init();
    MX_USART1_UART_Init();
    HAL_UART_Receive_DMA(&huart1,&ch, 1);
}

void gps_service_deinit(void)
{
    HAL_NVIC_DisableIRQ(DMA1_Stream2_IRQn);
    HAL_NVIC_DisableIRQ(DMA1_Stream7_IRQn);
    HAL_UART_MspDeInit(&huart1);

}


void gps_service_put_char_handle(void)
{
    if (ch == '$') {
        GPS_State.find_header = true;
    }

    if (ch == '\n' && GPS_State.find_header == true)
    {
        static uint8_t  buffer[81] = {0};
        memcpy(buffer, GPS_State.gps_buffer, GPS_State.in_ptr);

        GPS_State.data_ready = false;
        _gps_parser(buffer);
        GPS_State.data_ready = true;

        GPS_State.in_ptr = 0;
        GPS_State.find_header = false;
        return;
    }
    else
    {
        GPS_State.gps_buffer[GPS_State.in_ptr] = ch;
        GPS_State.in_ptr++;
        if (GPS_State.in_ptr > GPS_UART_BUFFER)
            GPS_State.in_ptr = 0;
    }
}


void _gps_parser(uint8_t *data)
{

    switch (minmea_sentence_id(data, false)) {

        case MINMEA_INVALID: ULOG_ERROR("MINMEA_INVALID\n[MESSAGE] %s\n",data);
            break;

        case MINMEA_UNKNOWN:
            break;

        case MINMEA_SENTENCE_RMC: {
            struct minmea_sentence_rmc frame;
            if (minmea_parse_rmc(&frame, (char *) data)) {

                GPS_Data.latitude = (float)minmea_tocoord(&frame.latitude);
                GPS_Data.longitude = (float)minmea_tocoord(&frame.longitude);
                GPS_Data.gps_speed = (float)minmea_tofloat(&frame.speed);

                GPS_Data.time.hours = (uint8_t)frame.time.hours;
                GPS_Data.time.minutes = (uint8_t)frame.time.minutes;
                GPS_Data.time.seconds = (uint8_t)frame.time.seconds;

                GPS_Data.date.year = (uint8_t)frame.date.year;
                GPS_Data.date.month = (uint8_t)frame.date.month;
                GPS_Data.date.day = (uint8_t)frame.date.day;

            }
        }
            break;

        case MINMEA_SENTENCE_GGA: {
            struct minmea_sentence_gga frame;
            if (minmea_parse_gga(&frame, (char *) data)) {
                GPS_Data.fix_quality = (uint8_t)frame.fix_quality;
                GPS_Data.sats = (uint8_t)frame.satellites_tracked;
            }
        }
            break;

        case MINMEA_SENTENCE_GSA: {
            struct minmea_sentence_gsa frame;
            if (minmea_parse_gsa(&frame, (char *) data)) {
                GPS_Data.fix_type = (uint8_t)frame.fix_type;
                GPS_Data.hdop = (float) minmea_tofloat(&frame.hdop);
                GPS_Data.vdop = (float) minmea_tofloat(&frame.vdop);
                GPS_Data.pdop = (float) minmea_tofloat(&frame.pdop);
            }
        }
            break;

        case MINMEA_SENTENCE_GLL:
            break;

        case MINMEA_SENTENCE_GST:
            break;

        case MINMEA_SENTENCE_GSV:
            break;

        case MINMEA_SENTENCE_VTG:
            break;

        case MINMEA_SENTENCE_ZDA:
            break;
    }

}


GPS_Data_t* gps_service_execute(void)
{
    if (GPS_State.data_ready == true) {

        GPS_LOGGER("Latitude: %f\n", GPS_Data.latitude);
        GPS_LOGGER("Longitude: %f\n", GPS_Data.longitude);
        GPS_LOGGER("GPS speed: %.3f\n", GPS_Data.gps_speed);
        GPS_LOGGER("GPS fix quality: %d\n", GPS_Data.fix_quality);
        GPS_LOGGER("GPS fix type: %d\n", GPS_Data.fix_type);
        GPS_LOGGER("GPS sats: %d\n", GPS_Data.sats);
        GPS_LOGGER("GPS hdop: %.2f\n", GPS_Data.hdop);
        GPS_LOGGER("GPS vdop: %.2f\n", GPS_Data.vdop);
        GPS_LOGGER("GPS pdop: %.2f\n", GPS_Data.pdop);
        GPS_LOGGER("GPS Time: %d:%02d:%02d\n", GPS_Data.time.hours, GPS_Data.time.minutes, GPS_Data.time.seconds);
        GPS_LOGGER("GPS Date: %02d.%02d.%d\n", GPS_Data.date.day, GPS_Data.date.month, GPS_Data.date.year);

        GPS_State.data_ready = false;
        return &GPS_Data;

    } else
        return NULL;

}
