cvetaevvitaliy/telemetry-system/(commit log)

2020-12-15 upload schematics
2020-12-15 upload CMake, STM HAL Library
    [OpeOCD_JLink_f4.cfg, OpeOCD_ST-Link_f4.cfg]
2021-01-04 Pcb test (#5)
    * PCB-test: add test FW Ground station PCB
    * PCB-test: add command fot enable LED_2
    * PCB-test: add range test
    * PCB-test: refactor CMake, level optimisation -03
    * PCB-test: update Travis CI runner
2021-01-05 add FreeRTOS supprot to GroundStation (#6)
2021-01-19 CLI: bugfix cli input (#12)
    * CLI: bugfix cli input
    * fixed typo in comments
    [cli_config.h]
2021-01-19 add support reboot to DFU without BOOT0 pin
    [dfu.c, main.c, main.h]
2021-01-20 CMake: add custom command "make flash" for flash device via DFU (#14)
2021-01-28 fix "sd_command" if sd not initialized
    [sd_cli_cmd.c]
2021-01-29 sd_list: add skip hidden files and directories
    [sd_card.c, sd_cli_cmd.c]
2021-01-30 fix interrupt priority
